Larabee0/Uni-Nerfgun-Controller/Videos/readme.md

This is the folder for the video of controller and game/experience

1. MOSFET Test - https://youtu.be/985vnLJKNAo
2. Nerfgun Bread Board Test - https://youtu.be/UaYp2pI3HbE
3. Gyro Test - https://youtu.be/CMrmnC2eXOE
4. Game Demo (Unity Editor) - https://youtu.be/H8oDX_98cWs
5. Gun Demo with PCB stack - https://youtu.be/qPB6z2db73k
6. Final Demo Video - https://youtu.be/WaDtwA2EJBU
