Larabee0/Uni-Nerfgun-Controller/Images/readme.md

Broadly speaking the I went from 1-5 in the folder order

1. Reverse engineering the gun took a while the images aren't really in any order hopefully their names give a decent description

2. Bread board prototype - replacing the stock control board with something entirely controlled by and Arduino (an ESP8266 NODE MCU in this case)

3. PCB the bread board prototype is kinda unmanagable, so I 

4. PCB prototype plug it all in and get it working - it looks awful but it works dammit.

5. Assorted cad models and prints. the prefered phone mount is the side bar, but I made a backup one with existing models just in case.

6. Final prototype pictures, see videos folder for demo.

7. Contains various UML diagrams, electrical schematic and the first 6 folders somewhat formatted in a PDF.
