Larabee0/Uni-Nerfgun-Controller/Arduino/IO Map.xlsx

ESP8266
Label | GPIO | Input | Output | Notes
D0 | GPIO16 | no interrupt | no PWM or I2C support | HIGH at boot | Column1 | Gun Pins | behaviour | alt behaviour | Device | Pin | Interrupt | Column3 | Column2
 |  |  |  | used to wake up from deep sleep | Rotary Encoder | Common | 5v | gnd | - | - | -
D1 | GPIO5 | OK | OK | often used as SCL (I2C) | rate of fire switch | Common | gnd | 5v | - | - | -
D2 | GPIO4 | OK | OK | often used as SDA (I2C) | ammo detector | LDR | Anagloe | - | ESP8266 | A0 | no
D3 | GPIO0 | pulled up | OK | connected to FLASH button, boot fails if pulled LOW |  | LED | Output | - | ESP8266 | D0 | no
D4 | GPIO2 | pulled up | OK | HIGH at boot | PCF8574 | scl | i2c | i2c | ESP8266 | t | -
 |  |  |  |  | PCF8574 | sda | i2c | i2c | ESP8266 | D2 | -
 |  |  |  | connected to on-board LED, boot fails if pulled LOW | Rotary Encoder | ACW | Input_pullup | - | ESP8266 | D3 | yes
D5 | GPIO14 | OK | OK | SPI (SCLK) | Rotary Encoder | CW | Input_pullup | - | ESP8266 | D4 | yes
D6 | GPIO12 | OK | OK | SPI (MISO) | Motor | Flywheel | Output | - | ESP8266 | D5 | no
D7 | GPIO13 | OK | OK | SPI (MOSI) | Motor | trigger | Output | - | ESP8266 | D6 | no
D8 | GPIO15 | pulled to GND | OK | SPI (CS) | PCF8574 | INT | Input | - | ESP8266 | D7 | yes
 |  |  |  | Boot fails if pulled HIGH | Rotary Encoder | Button | Input | - | PCF8574 | P0 | yes
RX | GPIO3 | OK | RX pin | HIGH at boot |  | door open | Input | - | PCF8574 | P1 | yes | green | green
TX | GPIO1 | TX pin | OK | HIGH at boot |  | Mag Inserted | Input | - | PCF8574 | P2 | yes | White | brown
 |  |  |  | debug output at boot, boot fails if pulled LOW | rate of fire switch | F1 | Input | - | PCF8574 | P3 | yes | green | red
A0 | ADC0 | Analog Input | X |  | rate of fire switch | F2 | Input | - | PCF8574 | P4 | yes | green | orange
 |  | Board marking |  |  | flywheel switch | s1 | Input | - | PCF8574 | P5 | yes | blue | yellow
 | GPIO10 | SK |  | Output works | trigger switch | s2 | Input | - | PCF8574 | P6 | yes | white | green
 | GPIO9 | S3 |  | No OUTPUT | INPUT (pulldown) works | IMU | scl | i2c | i2c | PCF8574 | scl | -
 | GPIO8 | ?? |  | No OUTPUT | No INPUT (pulldown) | No INPUT_PULLDOWN | IMU | sda | i2c | i2c | PCF8574 | sda | -
 | GPIO11 | ?? |  | No OUTPUT | No INPUT (pulldown) | No INPUT_PULLDOWN
 | GPIO7 | ?? |  | No OUTPUT | No INPUT (pulldown) | No INPUT_PULLDOWN
 | GPIO6 | ?? |  | No OUTPUT | No INPUT (pulldown) | No INPUT_PULLDOWN
PCF8574
Label | GPIO | Input | Output | Notes
P0 |  | ?? | ??
P1 |  | ?? | ??
P2 |  | ?? | ??
P3 |  | ?? | ??
P4 |  | ?? | ??
P5 |  | ?? | ??
P6 |  | ?? | ??
P7 |  | ?? | ??
INT |  | ?? | ??
