Larabee0/Uni-Nerfgun-Controller/(list of files, cad)

Other CAD files:
CAD Files/PrintJob v2.stl
CAD Files/Backup Phone Holder v2.stl
CAD Files/Sidebar phone holder v3.stl
