Larabee0/Uni-Nerfgun-Controller/Arduino/Electrical Schematic.kicad_sch

## KiCad design Arduino/Electrical Schematic.kicad_sch (2024-03-10)

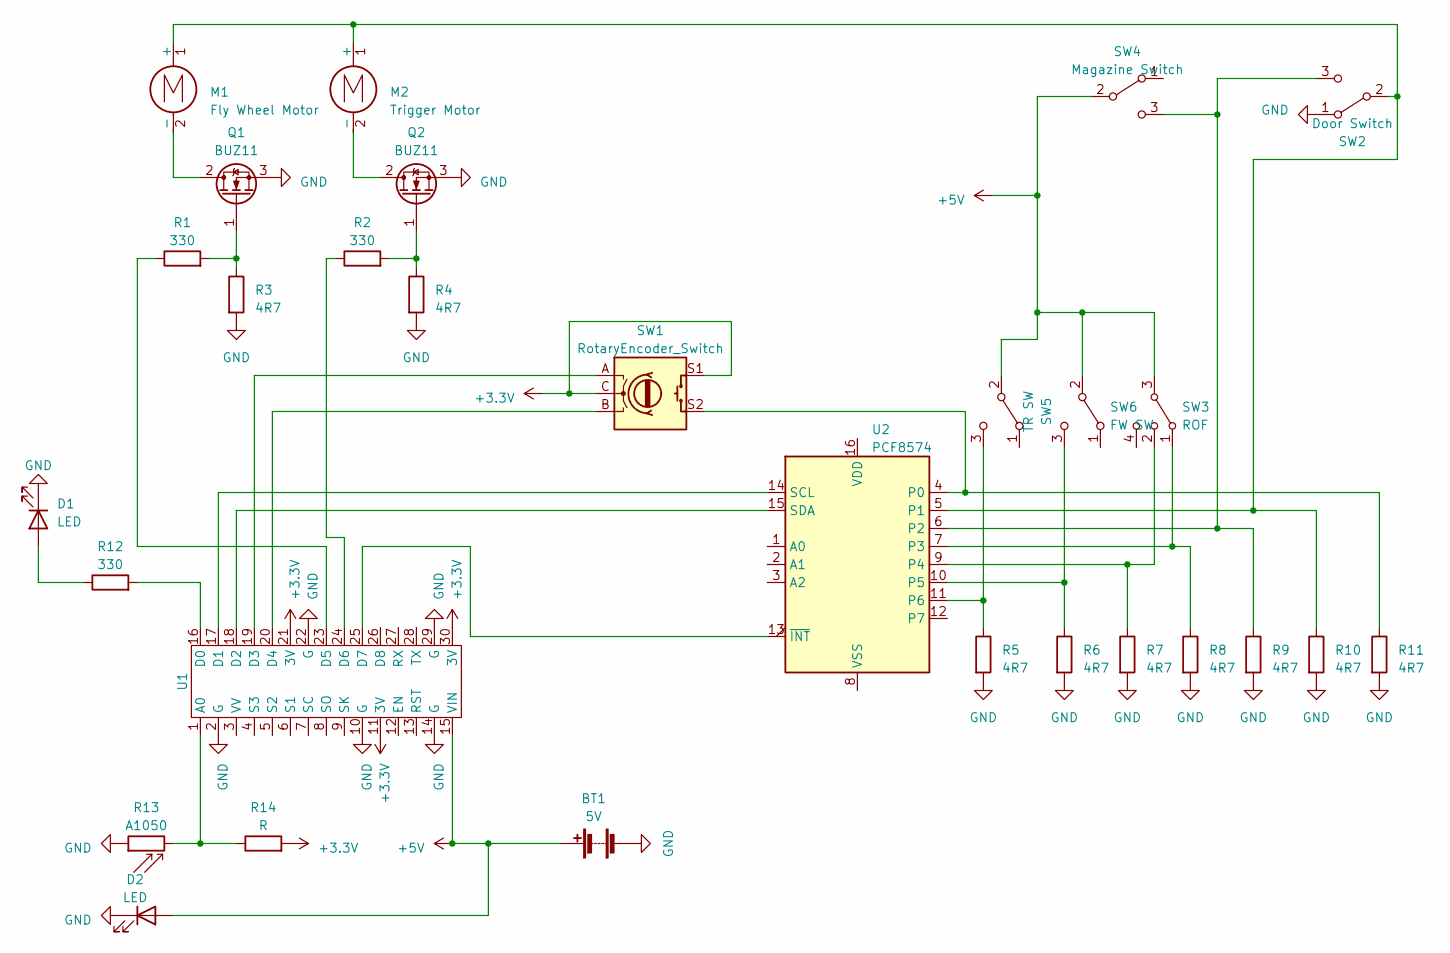
[picture p1: schematic Electrical Schematic.kicad_sch]

Parts:
BT1: 5V
D1, D2: LED
M1: Fly Wheel Motor
M2: Trigger Motor
Q1, Q2: BUZ11; TO-220-3_Vertical
R1, R2, R12: 330; R_Axial_DIN0207_L6.3mm_D2.5mm_P7.62mm_Horizontal
R3, R4, R5, R6, R7, R8, R9, R10, R11: 4R7; R_Axial_DIN0207_L6.3mm_D2.5mm_P7.62mm_Horizontal
R13: A1050; R_LDR_D6.4mm_P3.4mm_Vertical
R14: R
SW1: RotaryEncoder_Switch
SW2: Door Switch
SW3: ROF
SW4: Magazine Switch
SW5: TR SW
SW6: FW SW
U1: (no value)
U2: PCF8574

Connections:
+3.3V: R14.2, SW1.C, SW1.S1, U1.11 (3V), U1.21 (3V), U1.30 (3V)
+5V: BT1.1 (+), D2.2 (A), SW3.3, SW4.2 (B), SW5.2 (B), SW6.2 (B), U1.15 (VIN)
GND: BT1.2 (-), D1.1 (K), D2.1 (K), Q1.3 (S), Q2.3 (S), R3.2, R4.2, R5.2, R6.2, R7.2, R8.2, R9.2, R10.2, R11.2, R13.1, SW2.1 (A), U1.2 (G), U1.10 (G), U1.14 (G), U1.22 (G), U1.29 (G)
unnamed: D1.2 (A), R12.1
unnamed: M1.1 (+), M2.1 (+), R10.1, SW2.2 (B), U2.5 (P1)
unnamed: M1.2 (-), Q1.2 (D)
unnamed: M2.2 (-), Q2.2 (D)
unnamed: Q1.1 (G), R1.2, R3.1
unnamed: Q2.1 (G), R2.2, R4.1
unnamed: R1.1, U1.23 (D5)
unnamed: R2.1, U1.24 (D6)
unnamed: R5.1, SW5.3 (C), U2.11 (P6)
unnamed: R6.1, SW6.3 (C), U2.10 (P5)
unnamed: R7.1, SW3.2, U2.9 (P4)
unnamed: R8.1, SW3.1, U2.7 (P3)
unnamed: R9.1, SW2.3 (C), SW4.3 (C), U2.6 (P2)
unnamed: R11.1, SW1.S2, U2.4 (P0)
unnamed: R12.2, U1.16 (D0)
unnamed: R13.2, R14.1, U1.1 (A0)
unnamed: SW1.A, U1.19 (D3)
unnamed: SW1.B, U1.20 (D4)
unnamed: U1.17 (D1), U2.14 (SCL)
unnamed: U1.18 (D2), U2.15 (SDA)
unnamed: U1.25 (D7), U2.13 (~INT)
