Larabee0/Uni-Nerfgun-Controller/Arduino/HTTPStuff/WiFiAPExamples/WiFiAPExamples.ino

/*
   Copyright (c) 2015, Majenko Technologies
   All rights reserved.

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
 * * Neither the name of Majenko Technologies nor the names of its
     contributors may be used to endorse or promote products derived from
     this software without specific prior written permission.

   THIS SOFTWARE IS PROVIDED BY THE COPYRIGHT HOLDERS AND CONTRIBUTORS "AS IS" AND
   ANY EXPRESS OR IMPLIED WARRANTIES, INCLUDING, BUT NOT LIMITED TO, THE IMPLIED
   WARRANTIES OF MERCHANTABILITY AND FITNESS FOR A PARTICULAR PURPOSE ARE
   DISCLAIMED. IN NO EVENT SHALL THE COPYRIGHT HOLDER OR CONTRIBUTORS BE LIABLE FOR
   ANY DIRECT, INDIRECT, INCIDENTAL, SPECIAL, EXEMPLARY, OR CONSEQUENTIAL DAMAGES
   (INCLUDING, BUT NOT LIMITED TO, PROCUREMENT OF SUBSTITUTE GOODS OR SERVICES;
   LOSS OF USE, DATA, OR PROFITS; OR BUSINESS INTERRUPTION) HOWEVER CAUSED AND ON
   ANY THEORY OF LIABILITY, WHETHER IN CONTRACT, STRICT LIABILITY, OR TORT
   (INCLUDING NEGLIGENCE OR OTHERWISE) ARISING IN ANY WAY OUT OF THE USE OF THIS
   SOFTWARE, EVEN IF ADVISED OF THE POSSIBILITY OF SUCH DAMAGE.
*/

/* Create a WiFi access point and provide a web server on it. */
#include <ArduinoJson.h>
#include <ArduinoJson.hpp>
#include <ESP8266WiFi.h>
#include <WiFiClient.h>
#include <ESP8266WebServer.h>
#include <ESP8266mDNS.h>

#ifndef APSSID
#define APSSID "ESPap"
#define APPSK "thereisnospoon"
#endif

/* Set these to your desired credentials. */
const char *ssid = "ESP8266 mDNS";
const char *password = "12345678";

int ledPin = 2;

ESP8266WebServer server(80);

void setup() {
  pinMode(ledPin, OUTPUT);
  digitalWrite(ledPin, LOW);
  delay(1000);
  Serial.begin(115200);
  Serial.print("Configuring access point...");
  Serial.println();
  /* You can remove the password parameter if you want the AP to be open. */
  WiFi.softAP(ssid, password);
  IPAddress myIP = WiFi.softAPIP();
  Serial.print("AP IP address: ");
  Serial.println(myIP);
  Serial.println("HTTP server started");

  if(MDNS.begin("esp8266")){
    Serial.println("mDNS resonder Started");
    
  }
  else{
    Serial.println("Error setting up mDNS responder!");
  }

  server.on("/",handleRoot);
  server.on("/helloWorld",HTTP_GET,handleJSON);
  server.on("/ledON",HTTP_GET,TurnLedOn);
  server.on("/ledOff",HTTP_GET,TurnLedOff);
  server.onNotFound(handleNotFound);
  server.begin();
  Serial.println("HTTP server started");
}

void loop() {
  server.handleClient();
}

/* Just a little test message.  Go to http://192.168.4.1 in a web browser
   connected to this access point to see it.
*/
void handleRoot() {
  server.send(200, "text/plain", "Hello world!");
}

void handleJSON(){
  StaticJsonDocument<200> doc;
  doc["sensor"] = "gps";
  doc["time"] = millis();
  JsonArray data = doc.createNestedArray("data");
  data.add(48.756080);
  data.add(2.302038);

  String buf;
  serializeJson(doc, buf);
  server.send(200,"application/json",buf);
  Serial.println(buf);
}

void TurnLedOn(){
  digitalWrite(ledPin, HIGH);
  server.send(200, "text/plain", "LED 1");
}

void TurnLedOff(){
  digitalWrite(ledPin, LOW);
  server.send(200, "text/plain", "LED 0");
}

void handleNotFound(){
  server.send(404, "text/plain", "404: Not found");
}
