Larabee0/Uni-Nerfgun-Controller/(commit log)

2024-03-10 From COMP102
    [Backup Phone Holder v2.stl, Electrical Schematic.kicad_sch, IO Map.xlsx, PrintJob v2.stl, Sidebar phone holder v3.stl]
2024-03-10 Updated modules, switched to android target
